ThoughtTaken27/tsa-north-star-animatronic/README.md

# The North Star - Harriet Tubman Animatronic Exhibit






"The North Star" is a portable Arduino animatronic exhibit built for the 2026 Tennessee TSA Animatronics event. When a viewer approaches, a PIR sensor starts the narration, the head turns, the lantern lights, the right arm moves through a syringe linkage, and the North Star LED turns on.

**Result:** 1st place at the Tennessee TSA State Championship.

## Competition Score

| Category | Score | Max |
| :--- | ---: | ---: |
| Model Appearance (x3 multiplier) | 27 | 30 |
| Model Function | 70 | 70 |
| Presentation / Interview | 30 | 30 |
| **Total** | **127** | **130** |

**Debugging record:** 23 distinct traps logged across the build — 15 hardware/software faults diagnosed and fixed, 8 conceptual errors caught before they cost anything, and 2 competition-window incidents. Two cost hardware. Full breakdown in [`docs/postmortem_failure_log.md`](./docs/postmortem_failure_log.md).

Judge feedback: "Met the prompt very well." The exhibit was self-contained (battery-powered, no laptop required) and judges specifically noted the clean internal circuitry during the shell reveal. See [`docs/evidence_summary.md`](./docs/evidence_summary.md) for the official rating form breakdown.

## System Summary

| Area | Final Build |
| :--- | :--- |
| Controller | Arduino Uno-compatible ATmega328P board |
| Trigger | HC-SR501 PIR motion sensor |
| Audio | DFPlayer Mini with microSD narration file |
| Motion | MG996R head servo, MG996R syringe-drive servo, SG90 lantern arm servo |
| Lighting | Warm white lantern LED, orange/amber North Star LED |
| Arm Drive | Closed two-syringe water circuit: MG996R pushes a 60 mL drive syringe on the base, 3/16 in vinyl tubing carries the pressure to a second 60 mL syringe at the shoulder, which raises the pointing arm |
| Power | 9V battery to Arduino barrel jack, switched 4xAA battery pack for servo rail, shared ground |
| Reliability Fixes | Servo rail capacitor, DFPlayer voltage divider, PIR warm-up protocol, syringe-linkage corrections |

## Behavior

1. The Arduino waits through a 60-second PIR warm-up window after power-on.
2. Motion on the PIR sensor starts the sequence.
3. Both LEDs briefly turn off (visual reset), then the lantern LED turns on.
4. The head servo turns toward the viewer.
5. The DFPlayer plays `/mp3/0001.mp3` and a millisecond clock starts.
6. The left arm raises the lantern.
7. At exactly 18 seconds after audio started, the syringe-drive servo moves the right arm linkage.
8. The North Star LED turns on during the pointing gesture.
9. Five seconds before the audio ends, the outro begins: left arm lowers, head turns away, lantern turns off.
10. The hydraulic servo returns to rest.
11. The North Star LED stays on as a beacon between rounds.
12. The system waits for the PIR sensor to go LOW, then re-arms for the next visitor.

The repository contains two firmware versions:

- **`tsa-north-star-animatronic.ino`** — A modular, non-blocking `millis()`-based FSM rewrite created after the competition for portfolio clarity. This version uses separate source files under `src/` for the state machine, actuators, sensors, and audio controller.
- **`firmware/firmware.ino`** — The actual blocking code that ran on the competition Arduino. This version uses `delay()`-based sequencing, the DFRobotDFPlayerMini library, and a `millis()`-clocked hydraulic arm that waits a precise number of seconds after audio starts before moving. The North Star LED stays on between rounds as a beacon.

Both versions share the same pin map, servo angles, and DFPlayer fallback behavior.

## System Design

```mermaid
flowchart TD
    Base["Plywood base\nArduino, breadboard, DFPlayer, PIR, speaker, batteries"]
    Spine["1/2 in PVC spine and shoulder crossbar"]
    HeadServo["MG996R head servo (D9)"]
    Head["Foam head"]
    LanternServo["SG90 lantern arm servo (D11)"]
    Lantern["Wood-stick lantern arm + warm white LED"]
    SyringeServo["MG996R syringe-drive servo (D6)"]
    DriveSyringe["60 mL drive syringe (on base)"]
    Tubing["3/16 in clear vinyl tubing"]
    OutSyringe["60 mL output syringe (at shoulder)"]
    RightArm["Right arm, pivots on a plain metal pin"]

    Base --> Spine
    Spine --> HeadServo --> Head
    Spine --> LanternServo --> Lantern
    Base --> SyringeServo --> DriveSyringe --> Tubing --> OutSyringe --> RightArm
```

```mermaid
flowchart LR
    PIR["PIR motion sensor (D7)"] --> Arduino["Arduino state machine"]
    Arduino --> Audio["DFPlayer narration (D2/D3)"]
    Arduino --> Lights["Lantern LED (D5)\nNorth Star LED (D4)"]
    Arduino --> Head["Head servo (D9)"]
    Arduino --> Arm["Syringe-drive servo (D6)"]
    Arduino --> Lantern["Lantern arm servo (D11)"]
```

## Repository Map

- [`tsa-north-star-animatronic.ino`](./tsa-north-star-animatronic.ino) - Arduino entry point and pin assignments (modular, non-blocking FSM version).
- [`firmware/firmware.ino`](./firmware/firmware.ino) - The blocking, linear-sequence firmware that ran at the state championship, preserved verbatim from the final pre-competition development session on April 10, 2026. This is the source-of-record version, not a flash dump read back off the board.
- [`src/StateEngine.cpp`](./src/StateEngine.cpp) - Non-blocking sequence state machine.
- [`src/Actuators.cpp`](./src/Actuators.cpp) - Ramped servo wrapper with safe angle limits.
- [`src/Sensors.cpp`](./src/Sensors.cpp) - PIR debounce handling.
- [`src/AudioController.cpp`](./src/AudioController.cpp) - DFPlayer serial packet interface.
- [`hardware/bom.md`](./hardware/bom.md) - Bill of materials and pin map.
- [`hardware/mechanical_assembly.md`](./hardware/mechanical_assembly.md) - Physical frame and linkage notes.
- [`hardware/schematics/system_schematic_ascii.txt`](./hardware/schematics/system_schematic_ascii.txt) - Text wiring diagram.
- [`docs/assembly_guide.md`](./docs/assembly_guide.md) - Assembly and calibration guide.
- [`docs/postmortem_failure_log.md`](./docs/postmortem_failure_log.md) - Real build failures and fixes.
- [`docs/historical_context.md`](./docs/historical_context.md) - Historical and presentation context.
- [`docs/engineering_notebook.md`](./docs/engineering_notebook.md) - Timeline and team roles.
- [`docs/evidence_summary.md`](./docs/evidence_summary.md) - Private-source evidence summary without personal/order data.
- [`CONTRIBUTING.md`](./CONTRIBUTING.md) - Development setup, commit convention, and claim-accuracy rules.
- [`CHANGELOG.md`](./CHANGELOG.md) - Versioned history of the repository and firmware.

## Build and Upload

1. Open [`tsa-north-star-animatronic.ino`](./tsa-north-star-animatronic.ino) in the Arduino IDE.
2. Select **Arduino Uno** as the board.
3. Install the standard `Servo` library if it is not already installed.
4. Format the microSD card as FAT32.
5. Create a folder named `mp3` on the card.
6. Save the narration as `0001.mp3` inside that folder.
7. Upload the sketch.
8. Open Serial Monitor at `115200` baud for state transition logs.

The competition firmware in [`firmware/firmware.ino`](./firmware/firmware.ino) logs at `9600` baud, not 115200, and additionally requires the `DFRobotDFPlayerMini` library.

## Media

| Photo | What it shows |
| :---: | :--- |
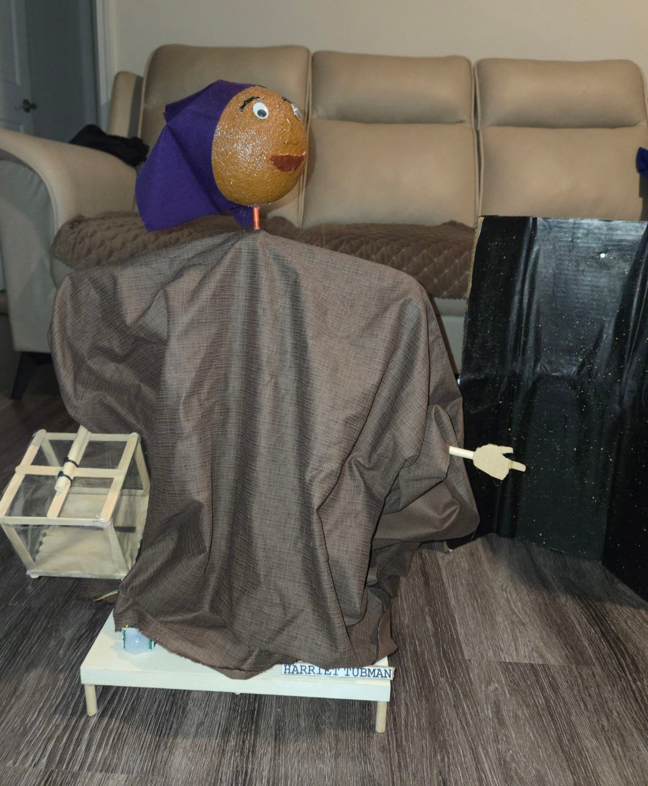
[picture p1: docs/assets/exhibit.jpg]
Exhibit
|  | Completed exhibit with fabric shell, painted head, and name plaque. |
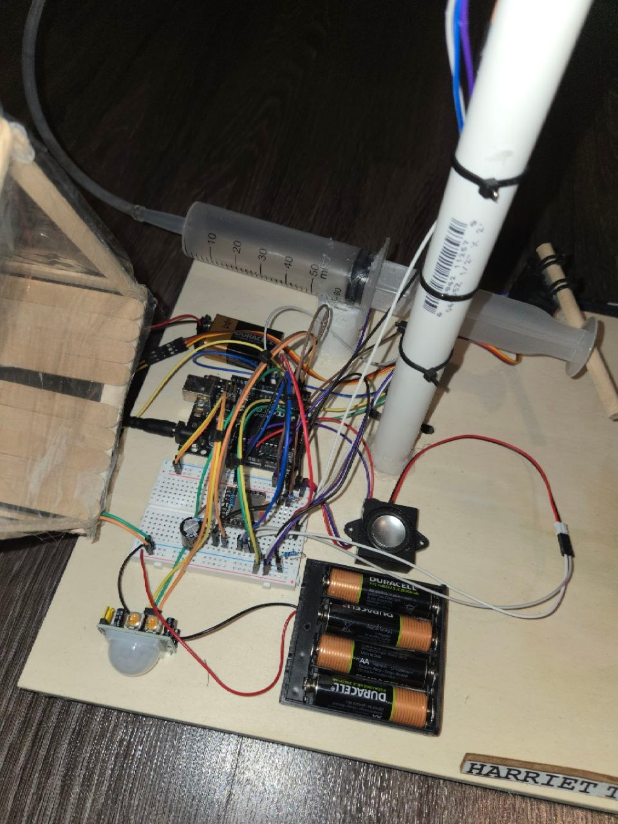
[picture p2: docs/assets/wiring.jpg]
Wiring
|  | Electronics layout: Arduino Uno, breadboard, DFPlayer, speaker, PIR, and battery pack on the white-painted base. |
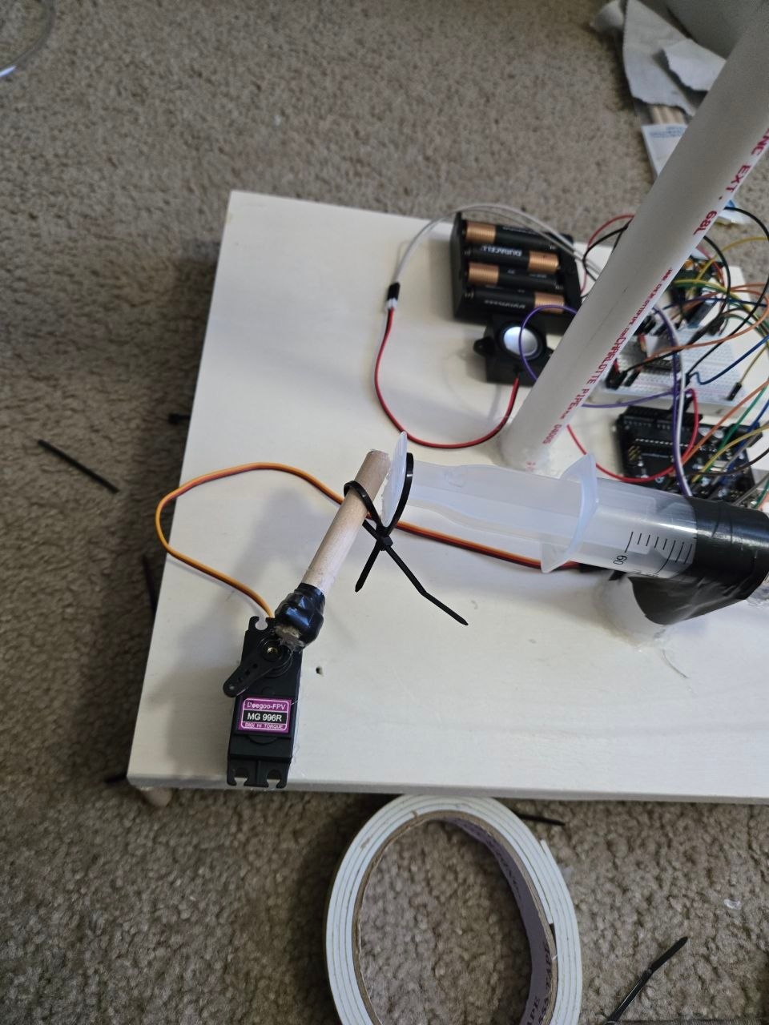
[picture p3: docs/assets/syringe_linkage.jpg]
Syringe linkage
|  | MG996R servo driving the 60 mL drive syringe through a wooden dowel linkage, on the white-painted base. |
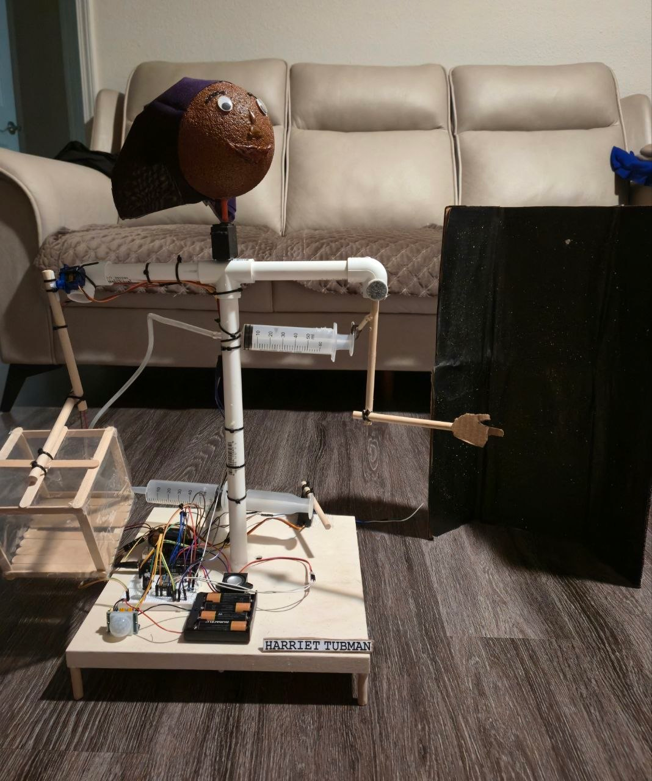
[picture p4: docs/assets/reveal.jpg]
Reveal
|  | Internal PVC skeleton with both arms, both syringes, the tubing run, and all servos exposed for judge inspection. |

A short full-sequence demo clip (`docs/assets/demo_hook.gif`) will be added when available.
