ThoughtTaken27/tsa-north-star-animatronic/docs/evidence_summary.md

# Evidence Summary

This repository keeps public documentation separate from private proof files. The evidence below was reviewed locally, then summarized without order numbers, payment data, addresses, phone numbers, member IDs, or unredacted student information.

## Competition Result

- Event: Tennessee TSA State Leadership Conference, Animatronics (HS) - Team.
- Chapter: Ravenwood High School.
- Evaluation completed: April 10, 2026.
- Total score: 127 / 130.
- Subscores shown on the rating form:
  - Model appearance: 27 / 30.
  - Model function: 70 / 70.
  - Presentation/interview: 30 / 30.
- Judge comment excerpt: "Met the prompt very well."

## Purchased Electronics and Materials

Amazon purchase screenshots dated March 7, 2026 verify:

- ELEGOO UNO R3 Arduino-compatible ATmega328P board.
- Deegoo-FPV MG996R metal gear digital servo 2-pack.
- Dorhea SG90 micro servo 5-pack.
- DFPlayer Mini MP3 player module.
- 8 GB TF/microSD cards with adapters.
- 3 W, 8 ohm mini speaker.
- HiLetgo HC-SR501 PIR motion sensor modules.
- FymuSing 1000 uF 25V electrolytic capacitors.
- Chanzon warm white 5 mm LEDs.
- Chanzon 60-value 1/4 W resistor kit.
- 60 mL plastic liquid syringes (multipack; two are in the final build as the drive and output halves of the fluid power circuit, and two more were ruined during development by using dish soap as a plunger lubricant).
- 3/16 in inner diameter clear vinyl tubing (10 ft).
- Dupont jumper wires.
- 4xAA switched battery holder.
- 9V battery clip to barrel plug adapter.
- Small black nylon cable ties.

Store receipts verify additional PVC, craft, and display materials:

- Home Depot receipt dated March 13, 2026: 1/2 in PVC pipe, coupling, 90-degree elbow, and tee fitting.
- Walmart receipt dated March 28, 2026: foam ball, wood stick pack, and craft/fabric materials.

Project notes and build photos, rather than the supplied purchase screenshots, support the North Star (orange) LED and the 1/2 in PVC floor flange. Those items should not be described as receipt-verified unless a separate receipt is added.

## Photo-Verified Build Details

The four build photos in `docs/assets/` independently confirm the following, and are treated as authoritative for as-built state where they conflict with pre-competition planning notes:

- Plywood base painted white, standing on four short wooden dowel feet.
- Arduino Uno (blue ELEGOO board), 400-tie-point breadboard, DFPlayer Mini seated on the breadboard, electrolytic capacitor on the servo rail, 3 W speaker, 9V battery with barrel adapter, and the switched 4xAA holder all mounted openly on the base.
- HC-SR501 PIR at the front of the base with both potentiometers and the trigger-mode jumper visible.
- MG996R drive servo pushing the base syringe plunger through a wooden dowel taped to the servo horn; the syringe is zip-tied to the base.
- A second 60 mL syringe mounted at the shoulder with vinyl tubing running to it — confirming the two-syringe master/slave circuit.
- No servo body at the right shoulder joint. The arm pivots on a plain metal pin through a drilled hole; the joint is entirely passive. Pre-competition planning notes had floated using a gutted SG90 body as the dead hinge, which is not what was built.
- SG90 lantern arm servo zip-tied to the opposite end of the shoulder crossbar, wires intact and connected.
- Craft-stick lantern frame, painted foam ball head with fabric headwrap, brown fabric shell, and a "HARRIET TUBMAN" placard on the base front.
- Black foam-board backdrop with painted/speckled stars.
- 4xAA holder loaded with NiMH rechargeable cells, so the servo rail was nearer 4.8V nominal than the 6V an alkaline set would give.

## Documented Cost

Available receipts show at least $183.63 in purchases:

| Source | Date | Total |
| :--- | :--- | ---: |
| Main Amazon electronics/materials order | March 7, 2026 | $140.95 |
| Amazon microSD card order | March 7, 2026 | $10.96 |
| Amazon speaker order | March 7, 2026 | $5.48 |
| Home Depot PVC/fittings receipt | March 13, 2026 | $6.45 |
| Walmart craft/materials receipt | March 28, 2026 | $19.79 |
| **Documented subtotal** |  | **$183.63** |

This figure should be described as a documented subtotal. It may not include reused tools, already-owned materials, batteries replaced during testing, or unrecorded consumables.
