ThoughtTaken27/tsa-north-star-animatronic/(commit log)

2026-06-25 refactor: rename firmware directory to src for recursive Arduino IDE compilation compliance
2026-06-25 Fix docs and code to match actual build
    Corrects 9 inaccurate claims identified by cross-referencing
    build notes from competition conversations:
    - Replace fictional dual AC adapter with real 4xAA battery pack
    - Replace EMI/cable theory with real PIR sensitivity dial fix + warm-up
    - Replace Delrin/O-ring seals with real tubing size/linkage fixes
    - Drop inflated '87 revisions' number
    - Fix DFPlayer voltage divider values (680Ω + 1KΩ)
    - Add file naming convention (0001_ prefix, mp3 folder)
    - Fix jaw animation: honest repeating pattern, not lip-sync
    - Add competition day details: forgotten backdrop, judge feedback
    - Update ASCII schematic to match actual wiring
    - Remove unsubstantiated materia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
    [StateEngine.cpp]
2026-07-03 refactor: extract magic numbers, guard redundant servo calls, improve schematic
    - Extract all hardcoded timing values and servo angles into named
    constants in StateEngine.h for tunability
    - Guard redundant setTarget() calls in StateEngine with last-target
    tracking to avoid re-commanding the same position every loop cycle
    - Rename lastSteadyState to lastRawState in Sensors for accuracy
    (variable tracks the raw digitalRead, not a steady/debounced state)
    - Rewrite ASCII schematic to match the actual physical build: painted
    foam head with googly eyes, purple mesh headwrap, PVC T-junction
    skeleton, blue SG90 on left shoulder, MG996R syringe drive on base,
    plywood base layout with all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
    [Sensors.cpp, Sensors.h, StateEngine.cpp, StateEngine.h]
2026-07-03 docs: add CI badge, CONTRIBUTING, and CHANGELOG for portfolio presentation (#1)
    * docs: add CI badge, CONTRIBUTING, and CHANGELOG for portfolio presentation
    - Display the GitHub Actions compile-workflow status badge in the README badge row so reviewers can see CI at a glance.
    - Add CONTRIBUTING.md documenting the dev setup, Conventional Commits convention, integrity script, and claim-accuracy rules.
    - Add CHANGELOG.md (Keep a Changelog / SemVer) seeded with the v1.0.0 competition build and reliability fixes.
    - Wire CONTRIBUTING.md and CHANGELOG.md into the README repository map.
    * docs: fix broken workflow link, fullwidth colon, and reconcile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
2026-07-04 fix: correct DFPlayer filename, document pin pivot, enhance postmortem accuracy
    - Fix 0001_harriet.mp3 → 0001.mp3 in all references (DFPlayer 0x12
    command requires 4-digit-numbered filenames in /mp3 folder)
    - Document right-arm passive pivot as plain metal pin, not SG90 servo
    (mechanical_assembly, schematic, assembly_guide)
    - Enhance PIR postmortem: unlabeled pin identification, correct knob
    positions, jumper cap setting
    - Add macOS dot_clean failure to postmortem (._ ghost files crash DFPlayer)
    - Merge stale [Unreleased] CHANGELOG section into v1.1 entry
    - Add CHANGELOG.md and CONTRIBUTING.md to verify_files.py link checking
    [StateEngine.cpp]
2026-07-08 Align modular firmware with competition behavior: DFPlayer fallback + North Star beacon LED; add official score breakdown to README
2026-07-10 fix: correct multiple factual errors against actual competition build
    - board_firmware_recovered.ino: replaced flash-dump reconstruction with the
    actual blocking competition code (DFRobotDFPlayerMini lib, 18s hydraulic
    delay, millis()-clocked audio sync, North Star beacon between rounds)
    - BOM/schematic: D2/D3 DFPlayer pin labels were swapped; D2 is Arduino RX
    (from DFPlayer TX direct), D3 is Arduino TX (to DFPlayer RX through divider)
    - tsa-north-star-animatronic.ino: fixed AudioController pin order to match
    actual wiring (RX=2, TX=3)
    - postmortem: PIR sensitivity potentiometer is fully counter-clockwise for
    max sensitivity on this HiLetgo revision, not clockwise
    - BOM: microSD ca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
    [StateEngine.h, board_firmware_recovered.ino, tsa-north-star-animatronic.ino]
2026-07-10 fix: move board_firmware_recovered.ino to firmware/ to fix CI
    Arduino CLI compiles all .ino files in the same directory together,
    causing duplicate setup()/loop() definitions. Moving the competition
    firmware to firmware/ isolates it from the main sketch.
    [board_firmware_recovered.ino]
2026-07-10 fix: correct dead code, volume, and add FSM vs competition disclaimer
    - GESTURE_HEAD_TURN_MS was 52000 but narration is only 33000ms (dead code). Fixed to 28000.
    - DFPLAYER_VOLUME was 20, competition used 30. Fixed to match.
    - Added header comment to modular version clarifying it is a post-competition
    redesign with intentionally different servo angles and timing, not a replica.
    Authoritative competition code is in firmware/board_firmware_recovered.ino.
    [StateEngine.h, tsa-north-star-animatronic.ino]
2026-07-10 fix: revert microSD to 8GB — pack was 16GB but each card is 8GB
2026-07-10 fix: correct 7 factual discrepancies against competition build record
    - postmortem: voltage divider pin D2→D3 (D2 is RX, not TX)
    - postmortem: remove fabricated dot_clean/resource fork claim,
    replace with actual DFPlayer issues (SD card seating, breadboard contact)
    - StateEngine.cpp: fix stale filename comment 0001_harriet.mp3→0001.mp3
    - bom.md + evidence_summary: add missing 3/16" vinyl tubing line item
    - schematic + assembly guide: distinguish modular FSM servo angles
    from competition firmware values (hydroRest=70/hydroPush=18, etc.)
    - CHANGELOG v1.1: correct PIR sensitivity direction (counter-clockwise,
    not clockwise for HiLetgo HC-SR501 revision)
    - CHANGELOG v1.2: update stale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
    [StateEngine.cpp]
2026-07-10 fix: exhaustive cross-check against competition build record
    - mechanical_assembly/schematic/assembly_guide: clarify hydraulic
    syringe + MG996R servo mounted ON TOP of plywood base
    - postmortem: add missing failure entries (hydraulic stiction/soap,
    air entrapment, servo grinding) with renumbered sections
    - schematic: remove misleading '32GB or smaller' SD card note
    (FAT32 is the real constraint, not capacity)
    - CI: add compile step for competition firmware
    (board_firmware_recovered.ino was not being CI-verified)
    - verify_files.py: add firmware/board_firmware_recovered.ino to
    required files list
2026-07-10 replace: wiring.jpg with clearer electronics layout photo
2026-07-10 fix: rename firmware file to match Arduino CLI sketch convention, fix CI
    [firmware.ino, tsa-north-star-animatronic.ino]
2026-08-05 fix: full accuracy audit against build record and photos
    Corrects fabricated, reversed, and omitted claims across the repository.
    Docs and hardware notes only; no firmware changes.
    - Remove fabricated hydraulic fill procedure (submerged tubing / fluid
    reservoir); replace with the actual four-step air-bleed sequence.
    - Reverse stiction causality: dish soap stripped the factory seal coating;
    the coating did not cause stiction. Two syringes were lost to it.
    - Correct the PIR failure symptom: it would not trigger for roughly two days,
    it was not false-triggering. Record the likely-damaged first sensor with
    the same hedge the build notes use.
    - Document the two-syringe master/slave fluid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
2026-08-05 fix: correct hydraulic fill method and stop overclaiming the audio file
    Second audit pass, this time on the claims added by the first pass.
    - Hydraulic fill procedure replaced with the method actually used: submerge
    one syringe and draw the plunger up until the barrel is bubble-free,
    attach tubing to that nozzle only, push the plunger in slowly over a sink
    until water fills the tube, then couple the second empty syringe while the
    end is still wet. The previous wording ("fill one syringe completely") was
    underspecified about how the barrel was filled.
    - Stop claiming the competition narration was plain and unprocessed. The
    build log records a voice-changer-processed file on the c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
2026-08-05 docs: add debugging scale summary and fix failure log numbering
    - Add a scale-of-effort table to docs/postmortem_failure_log.md and a one
    line summary to the README: 23 logged traps across the build, split into
    15 hardware/software faults diagnosed and fixed, 8 conceptual errors
    caught before they cost anything, and 2 competition-window incidents.
    - Name the two that cost hardware: one PIR sensor and two 60 mL syringes.
    - Note that the DFPlayer Mini alone accounted for four separate failure
    causes plus a macOS toolchain failure that looked like a fifth.
    - Fix a numbering gap in the failure log, which skipped section 12.
